cyril-j-bernardo/radiation-beam-degrader/Cynthia's Files/H-bridge/IMG_0622.JPG

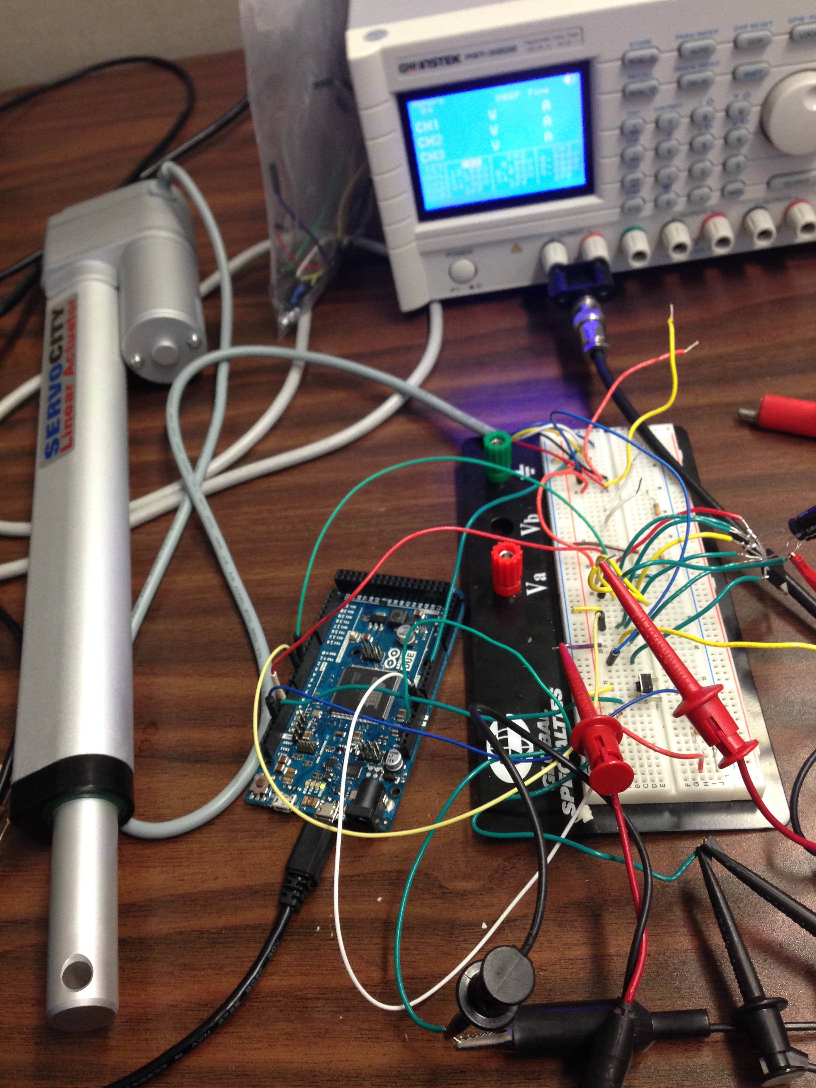
Cynthia's Files/H-bridge/IMG_0622.JPG
