cyril-j-bernardo/radiation-beam-degrader/Cynthia's Files/H-bridge/1a432b1b-40ec-4fd0-aedd-d648b9ce6a57.jpg

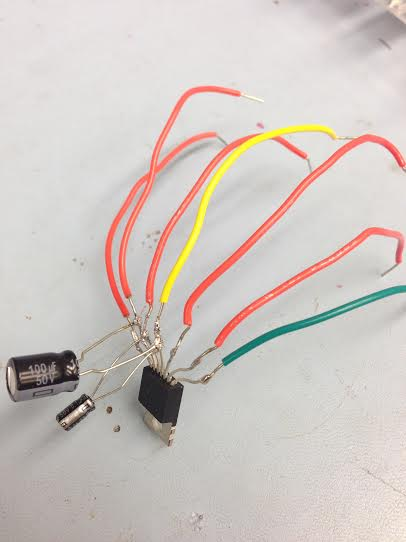
Cynthia's Files/H-bridge/1a432b1b-40ec-4fd0-aedd-d648b9ce6a57.jpg
