cyril-j-bernardo/radiation-beam-degrader/Cynthia's Files/GUI design/GUI-BeamDeg.docx

New Thickness:

mm

mm

5.1

WAIT

Beam Degrader GUI

Sheet Thickness

Enter

Previous Thickness:

12.80 mm :

0.40 mm :

0.80 mm :

Actuator Status

Reset all Actuators:

RESET

Status:

Power:

1.5

Error

Completely retracted

In progress

1.60 mm :

Completely extended

0.20 mm :

0.10 mm :

6.40 mm :

3.20 mm :

Completely extended

Completely retracted

Completely extended

Completely retracted

Completely retracted
