cyril-j-bernardo/radiation-beam-degrader/Cynthia's Files/GUI design/GUI-BeamDeg2.0.docx

ERROR

Beam Degrader GUI

Power:

Sheet Thickness

WAIT

Status:

RESET

Reset all Actuators:

Total Air gap Thickness: 2.26 mm

0.80 mm :

1.60 mm :

12.80 mm :

0.20 mm :

6.40 mm :

New Thickness:

mm

mm

5.1

Enter

Previous Thickness:

1.5

Completely extended

In progress

Completely retracted

Completely extended

Completely extended

Completely retracted

Completely retracted

Air gap 2: 0.20 mm

Completely retracted

Air gap 4: 0.53 mm5 mm

3.20 mm :

Air gap 5: 0.43 mm5 mm

Air gap 4: 0.53 mm5 mm

Air gap 3: 0.53 mm5 mm

0.40 mm :

Air gap 2: 0.20 mm

Air gap 1: 0.30 mm

0.10 mm :

Actuator Status
