cyril-j-bernardo/radiation-beam-degrader/Cynthia's Files/H-bridge/IMG_0624.JPG

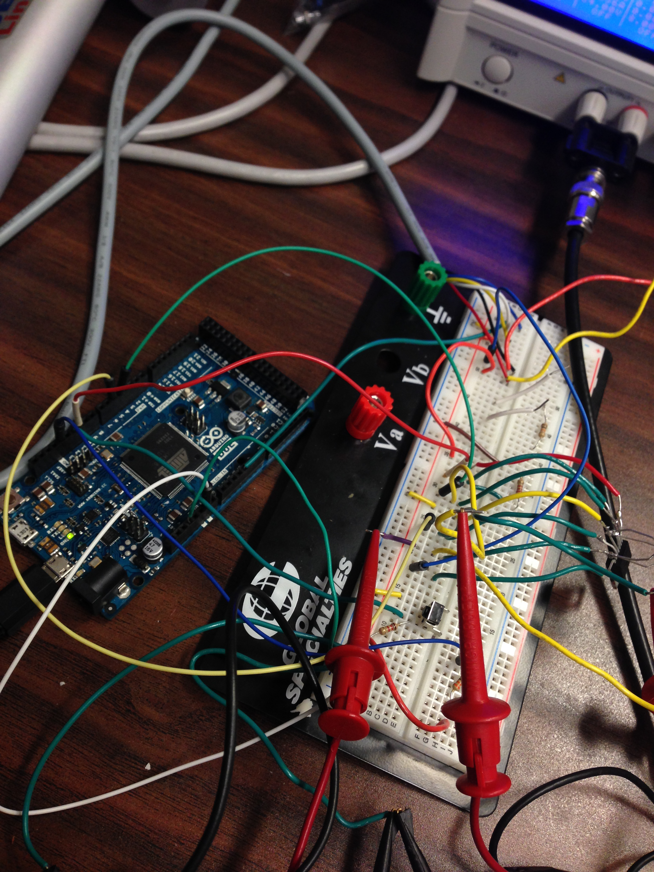
Cynthia's Files/H-bridge/IMG_0624.JPG
