cyril-j-bernardo/radiation-beam-degrader/Cynthia's Files/AltiumDesigner/BeamActuatorDriverboard_wc(mostrecent)/BeamActuatorDriverBoard.pdf

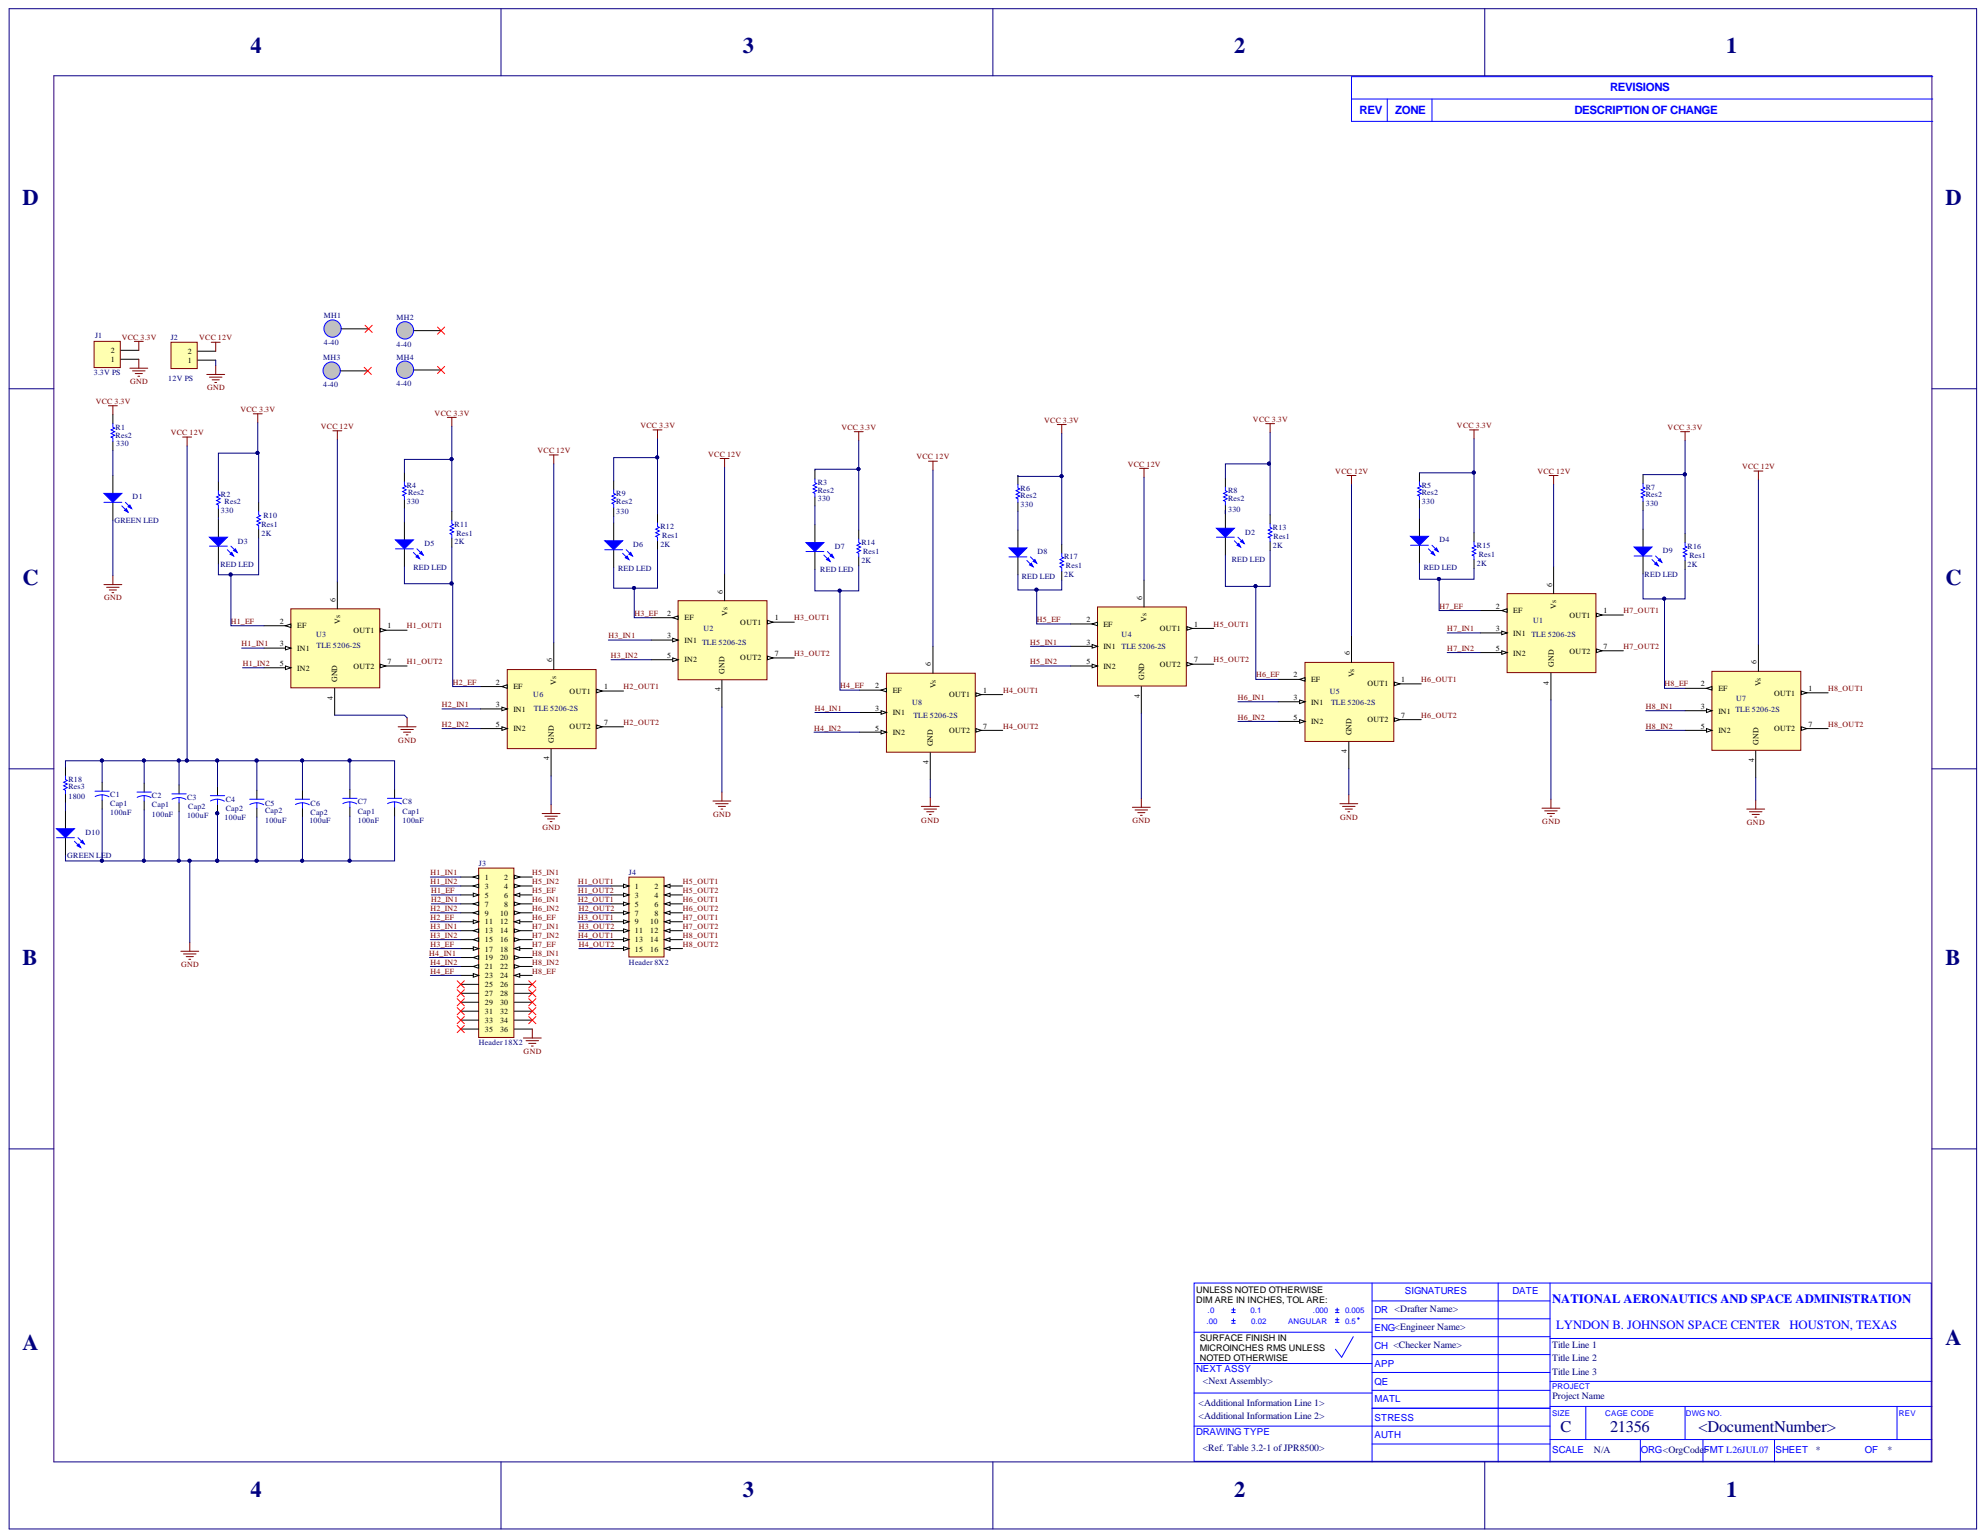
[picture p33: page 1]

U N LESS N O TED O T HER W ISE D I M ARE I N I N C HES, T O L ARE: . 0 0 . 1 . 0 0 0 0 . 0 0 5 . 0 0 0 . 0 2 A NGU L A R 0 . 5 | G N A T U R E S | D A T E | NATIONAL AERONAUTICS AND SPACE ADMINISTRATIO N LYNDON B. JOHNSON S

SSI E N G <Engineer Name>

SU R FACE F I N ISH I N M I C R O I N C HES R MS U N LESS N O TED O T HER W ISE | C H <Checker Name> | | PACE CENTER HOUSTON, TEXAS FMT L26JUL07 T i tle L ine 1 T i tle L ine 2 T i tle L ine 3

D R <D rafter Name>

<Addi tional Infor mation L ine 1> <Addi tional Infor mation L ine 2> | M A T L

S T R E S | | S IZE C | C AGE COD E 2 1 3 5 6 | D WG NO. <D ocumen tN umber> | R E V

D R AWI N G T Y P E <Ref. Table 3.2-1 of JPR8500> | A U T H
S C ALE N /A | O R G <O rgCode> | S H E E T * O F *

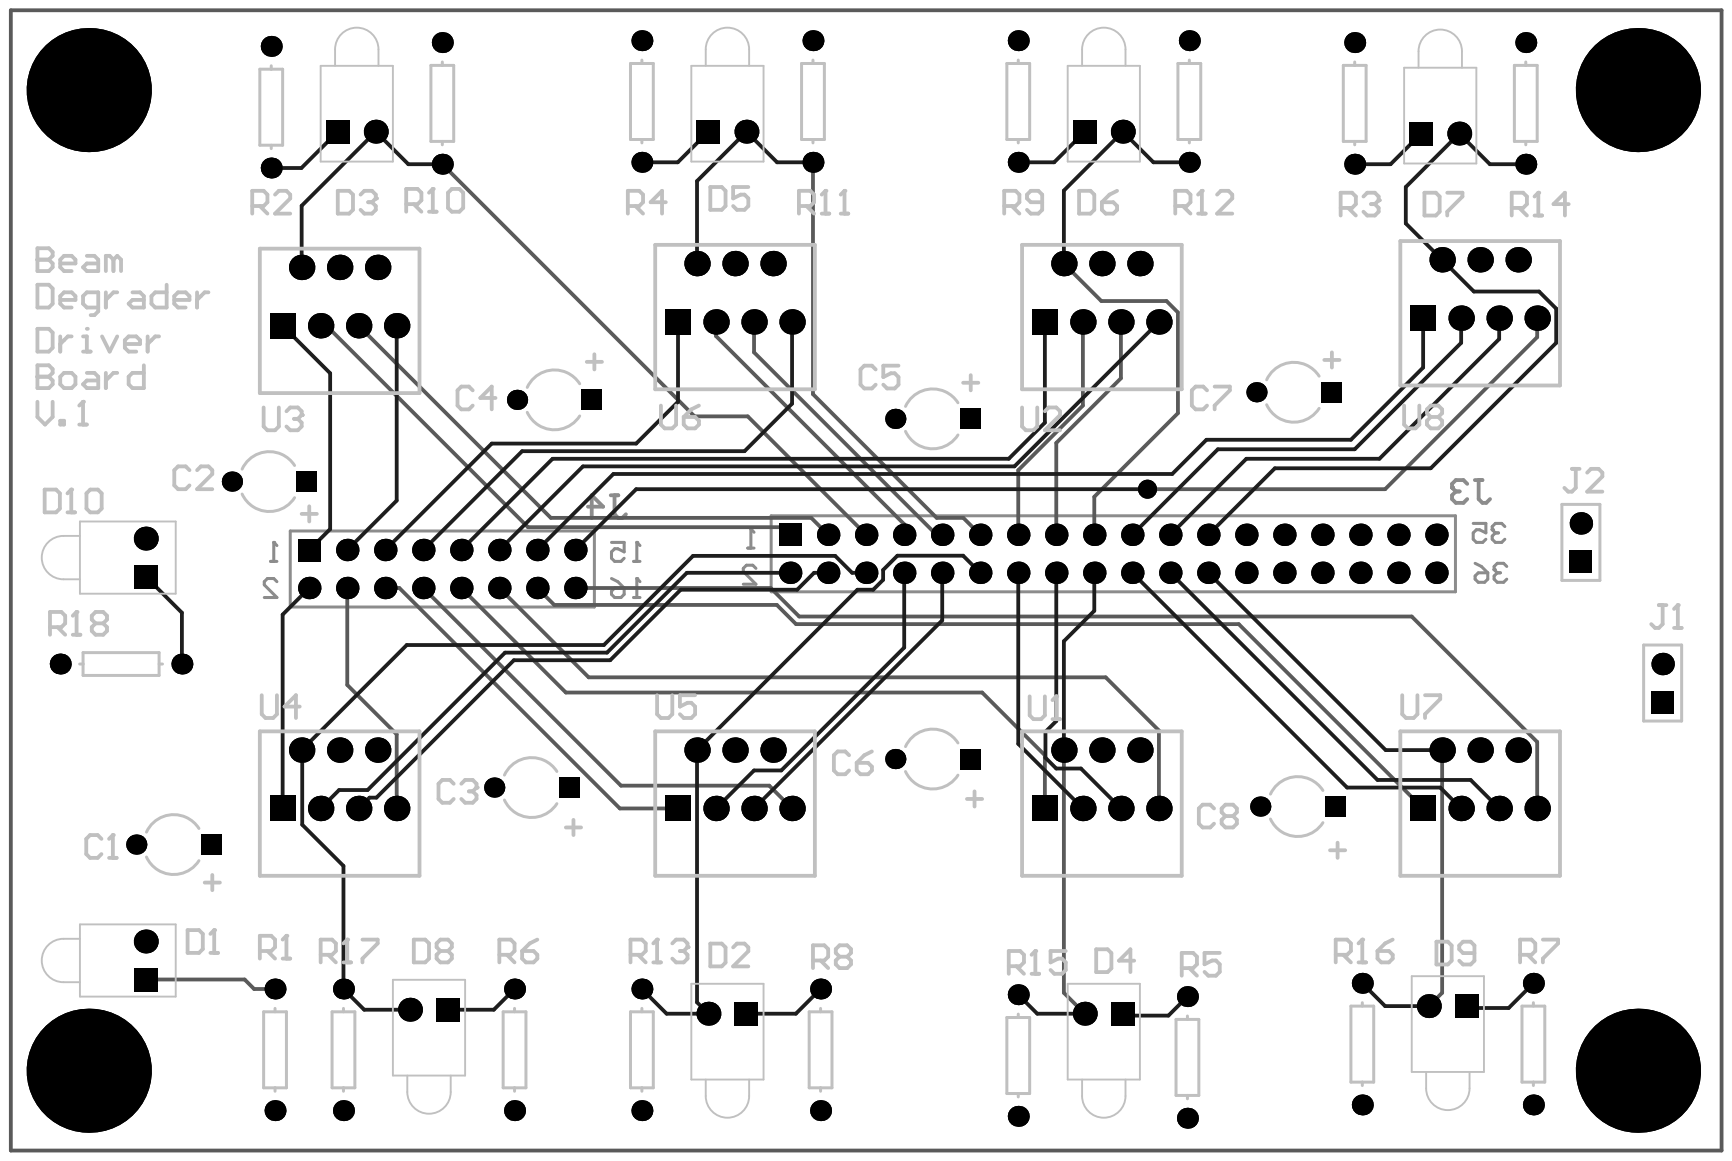
[picture p34: page 2]

# Board S
