cyril-j-bernardo/radiation-beam-degrader/(list of files, drawings)

Other design files:
Cynthia's Files/AltiumDesigner/AltiumLibrary/Miscellaneous Connectors - Copy/Miscellaneous Connectors.PcbLib
Cynthia's Files/AltiumDesigner/AltiumLibrary/Miscellaneous Connectors - Copy/Miscellaneous Connectors.SchLib
Cynthia's Files/AltiumDesigner/AltiumLibrary/Miscellaneous Devices - Copy/Miscellaneous Devices.PcbLib
Cynthia's Files/AltiumDesigner/AltiumLibrary/Miscellaneous Devices - Copy/Miscellaneous Devices.SchLib
Cynthia's Files/AltiumDesigner/BeamActuatorDriverBoard_(printed)/BeamActuatorDriverBoard.PrjPcb
Cynthia's Files/AltiumDesigner/BeamActuatorDriverBoard_(printed)/H-bridge.SchLib
Cynthia's Files/AltiumDesigner/BeamActuatorDriverBoard_(printed)/junk/H-bridge.SchLib
Cynthia's Files/AltiumDesigner/BeamActuatorDriverBoard_(printed)/junk/PCB1 - Copy (2).PcbDoc
Cynthia's Files/AltiumDesigner/BeamActuatorDriverBoard_(printed)/junk/PCB1 - Original(AutoRoute).PcbDoc
Cynthia's Files/AltiumDesigner/BeamActuatorDriverBoard_(printed)/junk/Sheet1.SchDoc
Cynthia's Files/AltiumDesigner/BeamActuatorDriverBoard_(printed)/PCB1 -2Layer.PcbDoc
Cynthia's Files/AltiumDesigner/BeamActuatorDriverBoard_(printed)/PCB1.PcbDoc
Cynthia's Files/AltiumDesigner/BeamActuatorDriverBoard_(printed)/PcbLib2.PcbLib
Cynthia's Files/AltiumDesigner/BeamActuatorDriverBoard_(printed)/Sheet1.SchDoc
Cynthia's Files/AltiumDesigner/BeamActuatorDriverboard_wc(mostrecent)/BeamActuatorDriverBoard.PrjPcb
Cynthia's Files/AltiumDesigner/BeamActuatorDriverboard_wc(mostrecent)/H-bridge.SchLib
Cynthia's Files/AltiumDesigner/BeamActuatorDriverboard_wc(mostrecent)/PCB1 -2Layer.PcbDoc
Cynthia's Files/AltiumDesigner/BeamActuatorDriverboard_wc(mostrecent)/PCB1.PcbDoc
Cynthia's Files/AltiumDesigner/BeamActuatorDriverboard_wc(mostrecent)/PcbLib2.PcbLib
Cynthia's Files/AltiumDesigner/BeamActuatorDriverboard_wc(mostrecent)/Sheet1.SchDoc
Cynthia's Files/AltiumDesigner/terminalstrip.SchDoc
