cyril-j-bernardo/radiation-beam-degrader/(commit log)

2016-08-24 first commit with cynthia's files
    [BeamActuatorDriverBoard.PrjPcb, H-bridge.SchLib, Miscellaneous Connectors.PcbLib, Miscellaneous Connectors.SchLib, Miscellaneous Devices.PcbLib, Miscellaneous Devices.SchLib, PCB1 - Copy (2).PcbDoc, PCB1 - Original(AutoRoute).PcbDoc]
2016-08-25 moved all of cynthia's files to one folder
    [BeamActuatorDriverBoard.PrjPcb, H-bridge.SchLib, Miscellaneous Connectors.PcbLib, Miscellaneous Connectors.SchLib, Miscellaneous Devices.PcbLib, Miscellaneous Devices.SchLib, PCB1 - Copy (2).PcbDoc, PCB1 - Original(AutoRoute).PcbDoc]
2016-08-25 confirmed actuators are working with time-dependent arduino program
2016-08-25 added main actuator control program for arduino
2016-08-29 test arduino code
2016-08-29 created actuator VI
